ozeidan9/Autonomous-Mars-Rover/Mobile App/rover-controller/resources/background.jpg

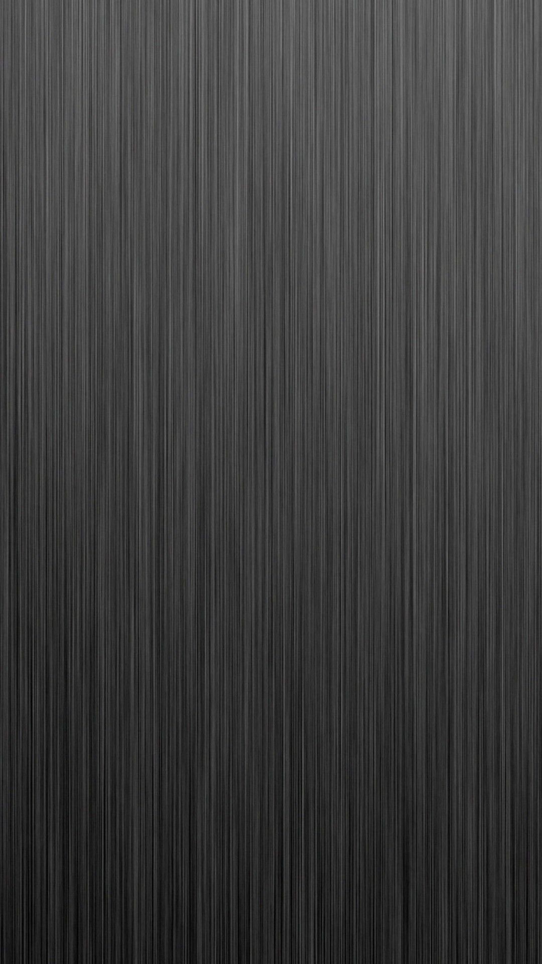
Mobile App/rover-controller/resources/background.jpg
