ozeidan9/Autonomous-Mars-Rover/Web App/Mapped_Unknown.jpg

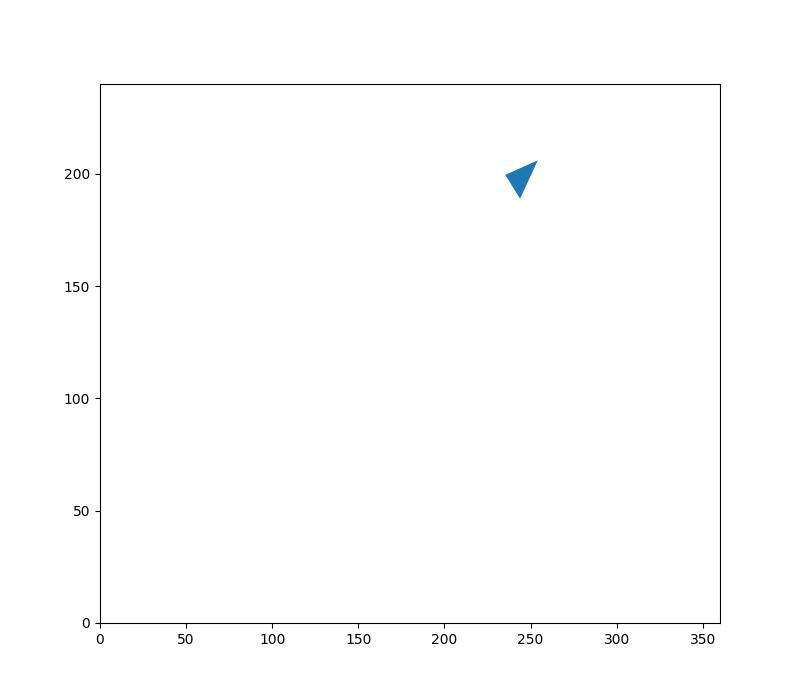
Web App/Mapped_Unknown.jpg
