ozeidan9/Autonomous-Mars-Rover/Web App/src/components/comp-resources/arena-map.jpg

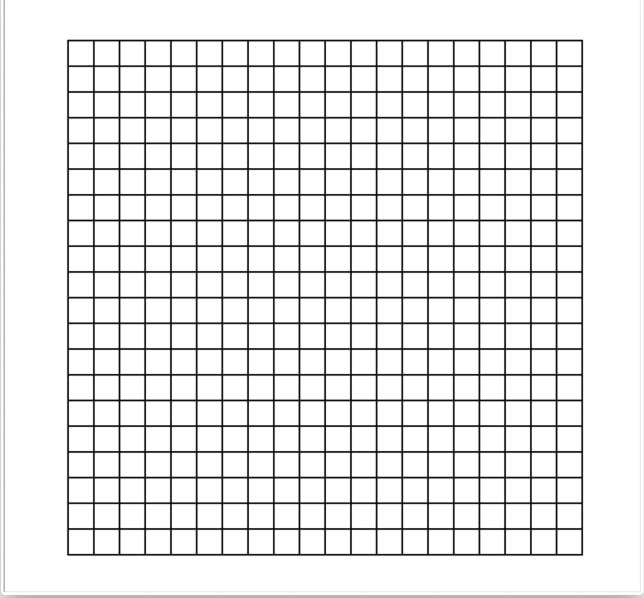
Web App/src/components/comp-resources/arena-map.jpg
