ozeidan9/Autonomous-Mars-Rover/Web App/src/components/comp-resources/Mapped_Unknown.png.jpg

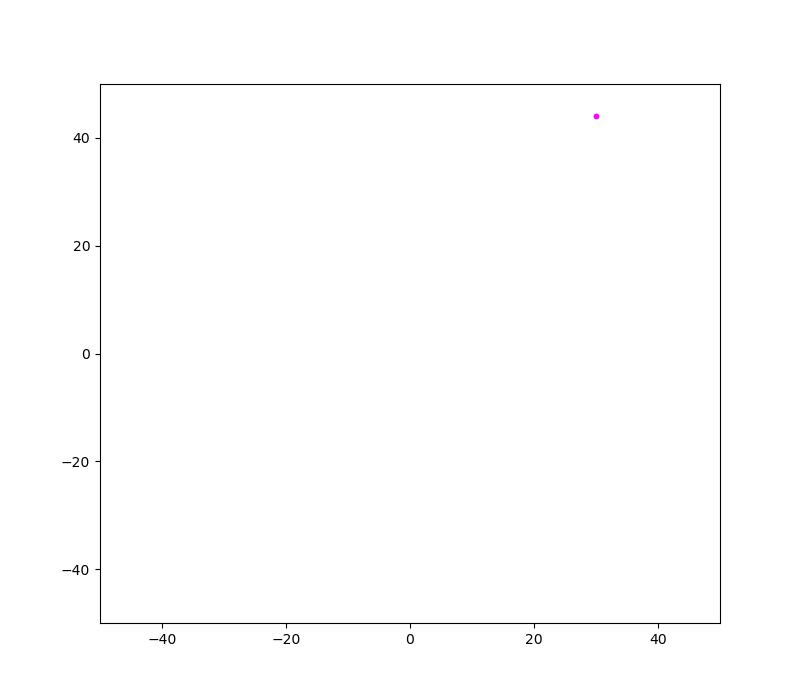
Web App/src/components/comp-resources/Mapped_Unknown.png.jpg
