ozeidan9/Autonomous-Mars-Rover/Control/Control.ino

#include "SPI.h"
#include <Robojax_L298N_DC_motor.h>
#include "WiFi.h"
//vision
bool red_found;
bool green_found;
bool yellow_found;
bool pink_found;
bool darkblue_found;
bool lightgreen_found;
int x_message;
bool building_done;
bool fourteen_reply;
unsigned long timee;
///////
//SPI settings
SPISettings settings(100000, MSBFIRST, SPI_MODE0);
SPIClass MySPI(HSPI);
uint8_t spi_counter[6]; // [0] = c20, [1] = c21, [2] = c22, [3] = c23, [4] = c24, [5] = c25
uint16_t spi_val, spi_val_prev1, spi_val_prev2;
uint16_t vision_msg;
uint8_t spi_reg;
uint16_t spi_returnval;
int spi_command;
int l;
int response;
bool will_read;
int last_read;
uint16_t colour_code;
uint16_t distrep;
uint16_t prev_distrep;
bool sent_dist;
int ball_counter = 0;
int vision_zero_counter = 0;
//////
//end of vision
bool object_measuring;
// these pins may be different on different boards
int motor1_val;
int motor2_val;
int motor_offset;
float desired = 0; //this will need to be a dynamic input connected to various things so it allows multiple directions instead of just one forward
unsigned long pathstart;//this should only be called during the update to record the time it takes for this new direction change, so this entire program needs to be called new each time the rover changes direction
//strt
//float pcoeff = 3;
//float icoeff = 0.025;
//float dcoeff = 3;
//float multiplier = 1;
float pcoeff = 3.6; //was 3.5, then 4.2
float icoeff = 0.005; //was 0.013, then 0.013
float dcoeff = 0.11; //was 0, then 0.2
float multiplier = 1;
//
//float pcoeff = 3.4;
//float icoeff = 0.02;
//float dcoeff = 3;
//float multiplier = 1;
//end
float ierror = 0;
float derror = 0;
float error;
unsigned long pathnow;
float correction;
//
uint8_t values[5];
int bytes_received;
bool angle_state = false;
bool distance_state = false;
int client_msg;
int opcode;
int magnitude;
char Commandchar;
int angle_reached;
int distance_reached;
//
#define PIN_SS        5
#define PIN_MISO      19
#define PIN_MOSI      23
#define PIN_SCK       18
#define PIN_MOUSECAM_RESET     35
#define PIN_MOUSECAM_CS        5
// TehCehPeh
#define RXP2 3
#define TXP2 1
// DRIVE
// motor 1 settings
#define CHA 0
#define ENA 2 // this pin must be PWM enabled pin if Arduino board is used D13 -> was 2
#define IN1 32 //D11
#define IN2 33 //D3 - was 15 (D12)
// motor 2 settings
#define IN3 21 //D4 //was 14  (D10)
#define IN4 16 //D9
#define ENB 17// this pin must be PWM enabled pin if Arduino board is used D8
#define CHB 1
#define ADNS3080_PIXELS_X                 30
#define ADNS3080_PIXELS_Y                 30
#define ADNS3080_PRODUCT_ID            0x00
#define ADNS3080_REVISION_ID           0x01
#define ADNS3080_MOTION                0x02
#define ADNS3080_DELTA_X               0x03
#define ADNS3080_DELTA_Y               0x04
#define ADNS3080_SQUAL                 0x05
#define ADNS3080_PIXEL_SUM             0x06
#define ADNS3080_MAXIMUM_PIXEL         0x07
#define ADNS3080_CONFIGURATION_BITS    0x0a
#define ADNS3080_EXTENDED_CONFIG       0x0b
#define ADNS3080_DATA_OUT_LOWER        0x0c
#define ADNS3080_DATA_OUT_UPPER        0x0d
#define ADNS3080_SHUTTER_LOWER         0x0e
#define ADNS3080_SHUTTER_UPPER         0x0f
#define ADNS3080_FRAME_PERIOD_LOWER    0x10
#define ADNS3080_FRAME_PERIOD_UPPER    0x11
#define ADNS3080_MOTION_CLEAR          0x12
#define ADNS3080_FRAME_CAPTURE         0x13
#define ADNS3080_SROM_ENABLE           0x14
#define ADNS3080_FRAME_PERIOD_MAX_BOUND_LOWER      0x19
#define ADNS3080_FRAME_PERIOD_MAX_BOUND_UPPER      0x1a
#define ADNS3080_FRAME_PERIOD_MIN_BOUND_LOWER      0x1b
#define ADNS3080_FRAME_PERIOD_MIN_BOUND_UPPER      0x1c
#define ADNS3080_SHUTTER_MAX_BOUND_LOWER           0x1e
#define ADNS3080_SHUTTER_MAX_BOUND_UPPER           0x1e
#define ADNS3080_SROM_ID               0x1f
#define ADNS3080_OBSERVATION           0x3d
#define ADNS3080_INVERSE_PRODUCT_ID    0x3f
#define ADNS3080_PIXEL_BURST           0x40
#define ADNS3080_MOTION_BURST          0x50
#define ADNS3080_SROM_LOAD             0x60
#define ADNS3080_PRODUCT_ID_VAL        0x17
WiFiClient client;
int distance_t = 0;
int angle_t = 0;
const int CCW = 2; // do not change
const int CW  = 1; // do not change
#define motor1 1 // do not change
#define motor2 2 // do not change
// for two motors without debug information // Watch video instruciton for this line: https://youtu.be/2JTMqURJTwg
Robojax_L298N_DC_motor robot(IN1, IN2, ENA, CHA,  IN3, IN4, ENB, CHB);
// for two motors with debug information
//Robojax_L298N_DC_motor robot(IN1, IN2, ENA, CHA, IN3, IN4, ENB, CHB, true);
char DriveMap[32]; //storage for drive's message
//char Command[32]; //storage for the actual command
const char* ssid = "AndroidAP5c48";//Wifi Name
const char* password = "janq9636";//Wifi password
const uint16_t port = 15000; //port number to connect to
const char * host = "192.168.43.192"; //IP to connect to (can be private or public)
bool drivemsgready = false; //bool which checks whether drive's message is ready for sending
bool alreadyconnected = false; //bool which checks whether the ESP32 has already connected with the server
bool Commandready = false; //bool which checks whether command is ready for sending command
bool SPIready = false;
//Event for when the ESP32 successfully connects as a Wifi Station
void WiFiConnected(WiFiEvent_t event, WiFiEventInfo_t info) {
  Serial.println("Connected to Web Backend successfully!");
}
//Event for when the ESP32 successfully receives it's local IP from the router
void WiFiGotIP(WiFiEvent_t event, WiFiEventInfo_t info) {
  Serial.println("WiFi connected");
  Serial.print("RRSI: ");
  Serial.println(WiFi.RSSI());
  Serial.println("IP address: ");
  Serial.println(WiFi.localIP());
}
//Event for when the ESP32 disconnects from the Wifi (tries to reconnect)
void WiFiDisconnected(WiFiEvent_t event, WiFiEventInfo_t info) {
  Serial.println("Disconnected from WiFi access point");
  Serial.print("WiFi lost connection. Reason: ");
  //Serial.println(info.disconnected.reason);
  Serial.println("Trying to Reconnect");
  WiFi.begin(ssid, password);
  Serial.print("Reconnecting to WiFi ..");
  while (WiFi.status() != WL_CONNECTED) {
    Serial.print('.');
    delay(1000);
  }
}
//Function for initialising connection to the WIFI
void initWiFi() {
  WiFi.mode(WIFI_STA);
  WiFi.begin(ssid, password);
  Serial.print("Connecting to WiFi ..");
  while (WiFi.status() != WL_CONNECTED) {
    Serial.print('.');
    delay(1000);
  }
}
int angle;
int total_x = 0;
int total_y = 0;
int total_x1 = 0;
int total_y1 = 0;
int x = 0;
int y = 0;
int a = 0;
int b = 0;
int distance_x = 0;
int distance_y = 0;
volatile byte movementflag = 0;
volatile int xydat[2];
//Multitasking
TaskHandle_t Optical_task;
int convTwosComp(int b) {
  //Convert from 2's complement
  if (b & 0x80) {
    b = -1 * ((b ^ 0xff) + 1);
  }
  return b;
}
struct MD
{
  byte motion;
  char dx, dy;
  byte squal;
  word shutter;
  byte max_pix;
};
int tdistance = 0;
void mousecam_reset()
{
  digitalWrite(PIN_MOUSECAM_RESET, HIGH);
  delay(1); // reset pulse >10us
  digitalWrite(PIN_MOUSECAM_RESET, LOW);
  delay(35); // 35ms from reset to functional
}
int mousecam_init()
{
  pinMode(PIN_MOUSECAM_RESET, OUTPUT);
  pinMode(PIN_MOUSECAM_CS, OUTPUT);
  digitalWrite(PIN_MOUSECAM_CS, HIGH);
  mousecam_reset();
  return 1;
}
byte frame[ADNS3080_PIXELS_X * ADNS3080_PIXELS_Y];
void mousecam_write_reg(int reg, int val)
{
  digitalWrite(PIN_MOUSECAM_CS, LOW);
  SPI.transfer(reg | 0x80);
  SPI.transfer(val);
  digitalWrite(PIN_MOUSECAM_CS, HIGH);
  delayMicroseconds(50);
}
int mousecam_read_reg(int reg)
{
  digitalWrite(PIN_MOUSECAM_CS, LOW);
  SPI.transfer(reg);
  delayMicroseconds(75);
  int ret = SPI.transfer(0xff);
  digitalWrite(PIN_MOUSECAM_CS, HIGH);
  delayMicroseconds(1);
  return ret;
}
void mousecam_read_motion(struct MD *p)
{
  digitalWrite(PIN_MOUSECAM_CS, LOW);
  SPI.transfer(ADNS3080_MOTION_BURST);
  delayMicroseconds(75);
  p->motion =  SPI.transfer(0xff);
  p->dx =  SPI.transfer(0xff);
  p->dy =  SPI.transfer(0xff);
  p->squal =  SPI.transfer(0xff);
  p->shutter =  SPI.transfer(0xff) << 8;
  p->shutter |=  SPI.transfer(0xff);
  p->max_pix =  SPI.transfer(0xff);
  digitalWrite(PIN_MOUSECAM_CS, HIGH);
  delayMicroseconds(5);
}
// pdata must point to an array of size ADNS3080_PIXELS_X x ADNS3080_PIXELS_Y
// you must call mousecam_reset() after this if you want to go back to normal operation
int mousecam_frame_capture(byte *pdata)
{
  mousecam_write_reg(ADNS3080_FRAME_CAPTURE, 0x83);
  digitalWrite(PIN_MOUSECAM_CS, LOW);
  SPI.transfer(ADNS3080_PIXEL_BURST);
  delayMicroseconds(50);
  int pix;
  byte started = 0;
  int count;
  int timeout = 0;
  int ret = 0;
  for (count = 0; count < ADNS3080_PIXELS_X * ADNS3080_PIXELS_Y; )
  {
    pix = SPI.transfer(0xff);
    delayMicroseconds(10);
    if (started == 0)
    {
      if (pix & 0x40)
        started = 1;
      else
      {
        timeout++;
        if (timeout == 100)
        {
          ret = -1;
          break;
        }
      }
    }
    if (started == 1)
    {
      pdata[count++] = (pix & 0x3f) << 2; // scale to normal grayscale byte range
    }
  }
  digitalWrite(PIN_MOUSECAM_CS, HIGH);
  delayMicroseconds(14);
  return ret;
}
void Opticaltaskcode(void *param){
  SPI.setClockDivider(SPI_CLOCK_DIV32);
  SPI.setDataMode(SPI_MODE3);
  SPI.setBitOrder(MSBFIRST);
 if (mousecam_init() == -1)
  {
    Serial.println("Mouse cam failed to init");
    while (1);
  }
  SPI.begin(); // init SPI bus
  for(;;){
    // if enabled this section produces a bar graph of the surface quality that can be used to focus the camera
    // also drawn is the average pixel value 0-63 and the shutter speed and the motion dx,dy.
    int val = mousecam_read_reg(ADNS3080_PIXEL_SUM);
    MD md;
    mousecam_read_motion(&md);
    distance_x = convTwosComp(md.dx);
    distance_y = convTwosComp(md.dy);
    total_x1 = total_x1 - distance_x;
    total_y1 = total_y1 + distance_y;
    total_x = total_x1 * 0.1008;   //callibrated;
    total_y = total_y1 * 0.0235;  //callibrated;
  }
}
void setup()
{
    timee = millis();
    object_measuring = false;
    delay(2000);
    Serial.println("started setup");
    Serial.begin(115200);
    building_done = false;
  // vision setup
    spi_val=-1;
    pinMode(15, OUTPUT);
    MySPI.begin(14, 4, 22, 15);
    spi_returnval = 0;
    red_found = 0;
    green_found = 0;
    yellow_found = 0;
    pink_found = 0;
    darkblue_found = 0;
    lightgreen_found = 0;
    response = 0;
    spi_val_prev1 = 0;
    spi_val_prev2 = 0;
 //Drive SPI setup
  pinMode(PIN_SS, OUTPUT);
  pinMode(PIN_MISO, INPUT);
  pinMode(PIN_MOSI, OUTPUT);
  pinMode(PIN_SCK, OUTPUT);
  WiFi.disconnect(true);
  robot.begin();
  //Second core shit...
  xTaskCreatePinnedToCore(
    Opticaltaskcode,
    "Optical_task",
    10000, //stack size in words
    NULL,  // input paramter to task
    0, //priority of task
    &Optical_task,
    0); //Core 0
  //initWiFi();
    WiFi.mode(WIFI_STA);
    WiFi.begin("AndroidAP5c48", "janq9636");
    Serial.print("Connecting to wifi...");
    while (WiFi.status() != WL_CONNECTED){
    Serial.print('.');
    delay(1000);
  }
  Serial.println("wifi connected");
  Serial.println(WiFi.localIP());
  client.connect(host, port);
  Serial.println("client connected");
  client.write("rover");
  Serial.println("line 547");
  sendtoServer(1, 0, 0);//initial sending of UPM
  delay(1000);
  Serial.println("end of setup");
}
char asciiart(int k)
{
  static char foo[] = "WX86*3I>!;~:,`. ";
  return foo[k >> 4];
}
//function to send sets of bytes to the server...
// void sendtoServer(int op,uint16_t first , uint16_t second){ //changed first and second to ints
//       memset(values, 0, 4); //just resetting the buffer
//       values[0] = op;
//       values[1] = (first & 65280)>>8;
//       values[2] = first & 255;
//       values[3] = (second & 65280)>>8;
//       values[4] = second & 255;
//       client.write(values, 5);
//       delay(100);
//  //sendtoSever(3,0,0)
// }
void sendtoServer(int op,int first , int second){ //changed first and second to ints
      uint16_t first_msg, second_msg;
      if(first < 0){
        first_msg = -first;
        first_msg+=32768;
      }
      else{
        first_msg = first;
      }
      if(second < 0){
        second_msg = -second;
        second_msg+=32768;
      }
      else{
        second_msg = second;
      }
      memset(values, 0, 4); //just resetting the buffer
      values[0] = op;
      values[1] = (first_msg & 65280)>>8;
      values[2] = first_msg & 255;
      values[3] = (second_msg & 65280)>>8;
      values[4] = second_msg & 255;
      client.write(values, 5);
      delay(100);
 //sendtoSever(3,0,0)
}
void loop()
{ 
  if(building_done == true & millis()-timee > 10000){
    building_done = false;
  }
  //  if((counter % 5) == 0){
  //    sendtoServer(0, 65484, 8396);
  //    counter++;
  //  }
  //  if((counter % 5) == 1){
  //    sendtoServer(1, 50, 60);
  //    counter++;
  //  }
//RE ADD ADDED ARDUINO CODE....
// start of vision loop
// Listening to vision:
    MySPI.beginTransaction(settings);
    digitalWrite(15, LOW);
    if(fourteen_reply == false){
        spi_val = MySPI.transfer16(0);
    }
    else{
        spi_val = MySPI.transfer16(14);
    }
    spi_returnval = 0;
    digitalWrite(15, HIGH);
    MySPI.endTransaction();
    if (spi_val != 0){
      Serial.println(spi_val);
    }
    if (spi_val == 9 || spi_val == 10) { 
        angle_state = true;
        if(object_measuring == false){
          Serial.println("now changing position");
          robot.brake(1);
          robot.brake(2);
          angle_t = total_x;
          distance_state = false;
          object_measuring = true;
        }
        else {
          Serial.println("started changing position");
          if(spi_val == 9){
            angle_t = total_x - 2;
          }
          else{
            angle_t = total_x + 2;
          }
        }
        distance_state = false;
        distance_t = total_y;
    }
    //no data
    else if (spi_val == 0){
        if(object_measuring){
            Serial.println("no longer measuring a ball");
            object_measuring = false;
            sendtoServer(2, 0, 0);
            sendtoServer(0, total_x, total_y);
            sendtoServer(1,0,0);
            if(fourteen_reply == true){
                fourteen_reply = false;
            }
        }
    }
    else if  (spi_val==13){
        spi_command = 0;
        SPIready = true;
        response=0;
        Serial.println("received 13. Too close!");
        ball_counter = 0;
    }
    else if  (spi_val==14){
        if(object_measuring == false & building_done == false ){
            fourteen_reply = true;
            object_measuring = true;
            robot.brake(1);
            robot.brake(2);
            angle_t = total_x;
            distance_t = total_y;
            distance_state = false;
        }
        // response=0;
        // if (will_read=true){
        // last_read=millis();
        // will_read=false;
        // spi_command = 0;
        // SPIready = true;
        // response=14;
        // sent_dist = false;
        // ball_counter = 0;
        Serial.println("received 14. requesting to measure building");
        //send back 14-                        ROHAN MA G let me know yeah
      }
    else if (spi_val ==-1){
        Serial.println("error failed to update spi connection");
        ball_counter = 0;
    }
    //detecting a ball/building
    else{
        distance_state = false;
        Serial.println("now measuring a distance");
        angle_t = total_x;
        distance_t = distance_y;
        angle_state = false;
        if(object_measuring = false){
          Serial.println("start of execution of ball measurement");
          robot.brake(1);
          robot.brake(2);
          distance_t = total_y;
          angle_t = total_x;
          angle_state = false;
          object_measuring = true;
        }
        else{
          robot.brake(1);
          robot.brake(2);
          colour_code = spi_val >> 11; //obtaining the colour code
          distrep = spi_val & 2047; //obtaining the message
          Serial.print("Colour_code: ");
          Serial.print(colour_code);
          Serial.print(" Distance: ");
          Serial.println(distrep);
          Serial.println("sending ball data to the server");
          sendtoServer(0, total_x, total_y);
          sendtoServer(2, colour_code, distrep);
          //registered the colour;
          Serial.println("telling fpga we have the data");
          MySPI.beginTransaction(settings);
          digitalWrite(15, LOW);
          if(colour_code == 7){
              spi_val = MySPI.transfer16(0);
              building_done = true;
          }
          else{
              spi_val = MySPI.transfer16(colour_code);
          }
          spi_returnval = 0;
          digitalWrite(15, HIGH);
          MySPI.endTransaction();
          delay(500);
          ball_counter = 0;
          if(fourteen_reply){
              fourteen_reply = false;
              building_done = true;
              timee = millis();
          }
          object_measuring = false;
          sendtoServer(1, 0, 0);
        }
    }
// end of vision loop
// ////////////////////////////////////////////////////////////////
// //////Receiving new command list from the server...//////////////
  Serial.println("checking for data from the server");
  if (!object_measuring && client.available())
  {
    // Serial.print("client available is high. number of bytes available is: ");
    // Serial.println(client.available());
    bytes_received = 0;
    while (client.available() && (bytes_received < 2)) {
      // Serial.println("received data from server: ");
      Commandchar = client.read(); //client.read() reads one character at a time
      // Serial.println(Commandchar);
      if(bytes_received == 0){
        client_msg = Commandchar << 8;
        // Serial.print("Halfway client message: ");
        // Serial.println(client_msg);
        bytes_received = 1;
      }
      else if(bytes_received == 1){
        client_msg += Commandchar;
        Serial.print("finished client message is: ");
        Serial.println(client_msg);
        opcode = client_msg >> 14;
        magnitude = client_msg & 16383;
        bytes_received = 2;
      }
    // Serial.print("received byte: ");
    // Serial.println(bytes_received);    
    }
    // Serial.print("Magnitude: ");
    // Serial.print(magnitude);
    //Angle
    // Serial.print("Opcode: ");
    // Serial.println(opcode);
    if(opcode==0){
        while(magnitude < 0){
          magnitude += 360;
        }
        while(magnitude > 360){
          magnitude -=360;
        }
        if(magnitude > 180 & magnitude < 360){
          magnitude = -(360-magnitude);
        }
        angle_t =  magnitude;
        distance_t = total_y;
        angle_state = true;
        distance_state = false;
        angle_reached = 0;
        distance_reached = 0;
    }
    //Dista
    else if(opcode == 1){
        if(magnitude > 500){
          distance_t = total_y -(magnitude-500);
        }else{
          distance_t = total_y + magnitude;
        }
        angle_t = total_x;
        angle_state = false;
        distance_state = true;
        angle_reached = 0;
        distance_reached = 0;
        desired = total_x;
    }
  }
      if((total_y > distance_t + 1 | total_y < distance_t - 1) && distance_state){
        distance_reached = 0;
        error =  desired - total_x;
        if(error == 0){
          ierror = 0;
        }else{
          ierror = ierror+error;
        }
        derror = error - derror;
        correction = multiplier*(error*pcoeff + ierror*icoeff + derror*dcoeff);
        if (total_y < distance_t-1){
          motor1_val = 43;
          motor2_val = 38;
          motor_offset = 3*angle_t - 3*total_x;
          robot.rotate(motor1, 44+correction, CW);//run motor1 at 60% speed in CW direction
          robot.rotate(motor2, 38-correction, CCW);//run motor1 at 60% speed in CW direction
        }
        if (total_y > distance_t + 1){
          motor1_val = 43;
          motor2_val = 38;
          motor_offset = 3*angle_t - 3*total_x;
          motor_offset = 3*angle_t - 3*total_x;
          robot.rotate(motor1, 44-correction, CCW);//run motor1 at 60% speed in CW direction
          robot.rotate(motor2, 38+correction, CW);//run motor1 at 60% speed in CW direction
        }
      }else if(distance_state){
        distance_reached = distance_reached + 1;
        robot.brake(1);
        robot.brake(2);
        //0-360 is all positive
        //-360 to 0 : 361 is -1, 362 is -2
        if(distance_reached >= 3){
          distance_reached = 0;
          distance_state = false;
          sendtoServer(0, total_x, total_y); //POS sent to server
          delay(100);
          // Serial.println("line 707");
          sendtoServer(1, 0, 0); // UPM sent to server
        }
          angle_state = false;
      }  
     if((total_x > angle_t + 1 | total_x < angle_t - 1) && angle_state){
       Serial.print("target angle is ");
       Serial.println(angle_t);
       Serial.print("actual angle is ");
       Serial.println(total_x);
       angle_reached = 0;
       if (total_x < angle_t-1){
         robot.rotate(motor1, 30, CW);//rxun motor1 at 60% speed in CW direction
         robot.rotate(motor2, 30, CW);//run motor1 at 60% speed in CW direction
       }
       if (total_x> angle_t + 1){
        //  Serial.println("too close");
         Serial.print("ideal x is: ");
        Serial.println(angle_t);
         Serial.print("total x is: ");
          Serial.println(total_x);
         robot.rotate(motor1, 30, CCW);//run motor1 at 60% speed in CW direction
         robot.rotate(motor2, 30, CCW);//run motor1 at 60% speed in CW direction
       }
     }else if(angle_state){
       angle_reached = angle_reached + 1;
       Serial.println("at correct angle");
       robot.brake(1);
       robot.brake(2);
     //0-360 is all positive
     //-360 to 0 : 361 is -1, 362 is -2
      if(angle_reached >= 3){
        robot.brake(1);
        robot.brake(2);
        angle_reached = 0;
        Serial.println("finished!");
        angle_state = false;   //RETURN LATER PLSSSSSS
        sendtoServer(0, total_x, total_y); //POS sent to server
        delay(100);
        sendtoServer(1, 0, 0); // UPM sent to server
      }
        distance_state = false;
     }
}
