ozeidan9/Autonomous-Mars-Rover/Web App/src/automate.py

from enum import auto
from operator import indexOf
import numpy as np

# map = np.zeros((240,360)) 
point=[]

poi = [ [] ]  # Points of interest
# Add corners of arena to poi
poi.append([26,26])#0
poi.append([180,26])#1
poi.append([334,26])#2
poi.append([334,214])#3
poi.append([180,214])#4
poi.append([26,214])#5
poi.append([120,120])#6
poi.append([240,120])#7


class Node(): #node class for A* pathfinding -> f = g + h

    def __init__(self, parent=None, position=None):
        self.parent = parent
        self.position = position

        self.g = 0
        self.h = 0
        self.f = 0

    def __eq__(self, other):
        return self.position == other.position


class Rover(): #node class for A* pathfinding -> f = g + h

    def __init__(self=None):

        self.distance = 0
        self.angle = 0

        self.x = 0
        self.y = 0
      

# def drive( x, y ):      #takes in current position of rover, don't we also need angle? 
    
     
#     while 0<y<360 and 0<x<240 and (manual == False):
        
#         print("brev")


def dead_zone(map, alien): #9x9 square deadzoen centred at alien or building
    
    x = alien[0]
    y = alien[1]

    
    for i in range(x-4, x+5):
        for k in range(y-4, y+5):

            if 0<=i<240 and 0<=y<360:
                map[i,k] = 1
    
    return map


def automate_route(map, start, end): # higher level function calls a star and other functions to route rover from point to point
    a_star_output = a_star(map, start, end)
    path_output = smoothbrudha(a_star_output)
    return path_output
    # sendtodrive(path_output)





def a_star(map, start, end): # closed box dead zone of 10x10 cm  -> Returns a list of tuples as a path from the given start to the given end in the given map
    # Create start and end node
    startNode = Node(None, start)
    startNode.g = startNode.h = startNode.f = 0     # A* algorothm formula for start node
    endNode = Node(None, end)
    endNode.g = endNode.h = endNode.f = 0           # A* algorothm formula for end node

    open = []   
    completed = []


    #Loop until we find the end node
    while len(open)>0:

        currentNode = open[0]  # retrieve the current node
        curr_index = 0
        for index, item in enumerate(open):
            if item.f < currentNode.f:
                currentNode = item
                curr_index = index

        # Pop current off open list, add to closed list
        open.pop(curr_index)
        completed.append(currentNode)

        # Found the goal
        if currentNode == endNode:
            path = []
            current = currentNode
            while current is not None:
                path.append(current.position)
                current = current.parent
            return path[::-1] # Return reversed path

        # Generate children
        children = []
        for new_position in [(0, -1), (0, 1), (-1, 0), (1, 0), (-1, -1), (-1, 1), (1, -1), (1, 1)]: # Adjacent squares

            # Get node position
            node_position = (currentNode.position[0] + new_position[0], currentNode.position[1] + new_position[1])

            # Make sure within range
            if node_position[0] > (len(map) - 1) or node_position[0] < 0 or node_position[1] > (len(map[len(map)-1]) -1) or node_position[1] < 0:
                continue

            # Make sure walkable terrain
            if map[node_position[0]][node_position[1]] != 0:
                continue

            # Create new node
            new_node = Node(currentNode, node_position)

            # Append
            children.append(new_node)

        # Loop through children
        for child in children:

            # Child is on the closed list
            for closed_child in completed:
                if child == closed_child:
                    continue

            # Create the f, g, and h values
            child.g = currentNode.g + 1
            child.h = ((child.position[0] - endNode.position[0]) ** 2) + ((child.position[1] - endNode.position[1]) ** 2)
            child.f = child.g + child.h

            # Child is already in the open list
            for open_node in open:
                if child == open_node and child.g > open_node.g:
                    continue

            # Add the child to the open list
            open.append(child)




def smoothbrudha(path_array): #outputs array of [angle1, distance1, angle2, distance2]
    max_x_coordnate =np.argmax( np.max(path_array, axis=0) )     #find max row element (max x element) -> axis=0 is row
    start_coordinate = path_array[0]            # initial [x,y] coordinate
    dy1 = max_x_coordnate[1] - start_coordinate[1]
    dx1 = max_x_coordnate[1] - start_coordinate[1]
    angle1 = np.arctan(dy1/dx1)
    distance1 = (dy1)^2 + (dx1)^2
    path_output = []
    path_output.append(angle1)
    path_output.append(distance1)

    end_coordinate = path_array[len(path_array)-1] 

    if max_x_coordnate==end_coordinate:
        path_output.append(0)
        path_output.append(0)
        
    else:
        dy2 = max_x_coordnate[1] - end_coordinate[1]
        dx2 = max_x_coordnate[1] - end_coordinate[1]
        angle2 = np.arctan(dy1/dx1) + angle1                # basic trig fam
        distance2 = (dy2)^2 + (dx2)^2
        path_output = []
        path_output.append(angle2)
        path_output.append(distance2)
    
    return path_output

    # implement minimum x case
    # implements if 3 corresponding x coordinates have same x value to make flat (straiught) line
    
    
    # for pos in path_array:
        

def smooth(path, weight_data = 0.5, weight_smooth = 0.1, tolerance = 0.00001):
    
    # Make a deep copy of path into newpath
    newpath = [[0 for col in range(len(path[0]))] for row in range(len(path))]
    for i in range(len(path)):
        for j in range(len(path[0])):
            newpath[i][j] = path[i][j]

    #### ENTER CODE BELOW THIS LINE ###
    change = 1
    while change > tolerance:
        change = 0
        for i in range(1,len(path)-1):
            for j in range(len(path[0])):
                ori = newpath[i][j]
                newpath[i][j] = newpath[i][j] + weight_data*(path[i][j]-newpath[i][j])
                newpath[i][j] = newpath[i][j] + weight_smooth*(newpath[i+1][j]+newpath[i-1][j]-2*newpath[i][j])
                change += abs(ori - newpath[i][j])
    
    return newpath # Leave this line for the grader!


    
def send_angle(angle):
    target_angle = rover.angle + angle
    return target_angle

def send_distance(distance):
    target_distance = rover.distance + distance
    return target_distance


def sendtodrive(path_output):
    for name in nicknames:
        if name=="rover":
            index = indexOf(name)
            break

    client = clients[index]
    #Add queue system...
    client.send["yo"]



#adv def CurvatiousBundaliciousBattyBunds():
def update_start(x,y,angle):
    if x == 20:
        if y==20:
            #driveto(26,26,90)
            stateinner= 0
        if y==220:
            #driveto(26,214,180)
            stateinner= 5
    if x == 340:
        if y==20:
            #driveto(334,26,-90)
            stateinner= 2
        if y==220:
            #driveto(324,214,0)
            stateinner= 3
    return (stateinner)
    

# def driveto(x,y,angle):

#     init_x = rover.x
#     init_y = rover.y
#     curr_loc = [init_x, init_y]

#     new_loc = calc_loc(angle,  ,curr_loc)
#     rover.x = new_loc[0]
#     rover.y = new_loc[1]



def nextpoint(state, poi,map):
    line_path = automate_route(map ,poi[point-1], poi[point])  # line_path = [angle1, d1, angle2, d2]
    return (line_path)
    #send to drive
    #sendtodrive

def command(point,state):
    line_path = automate_route(map ,poi[point], poi[point+1]) 
    if (point == 1 or point == 4):
        command.clear()
        command.append("6155") # left 155
        command.append("7155") #right 155
        

    if (point == 6 or point == 7):
        command.append("6180") # left 180
        command.append("6180") # left 180 
        
    else:
        command.append("9000") #radar on
        command.append("6065") # left 65
        command.append("7065") #right 65
        command.append("9100") #radar off
        print(command)
        return command

def exe(x,y,angle,state,serverstate):
    if serverstate == 1 :
        state=update_start(x,y)
    if serverstate==0:
        commandlist = command(point,state)
    
    return commandlist
    
