ozeidan9/Autonomous-Mars-Rover/Web App/src/automation_simulation.py

from cmath import sqrt
import numpy as np
import math


# start: 24,24
# end: 180,26


class Node():
    """A node class for A* Pathfinding"""

    def __init__(self, parent=None, position=None):
        self.parent = parent
        self.position = position

        self.g = 0
        self.h = 0
        self.f = 0

    def __eq__(self, other):
        return self.position == other.position

def astar(maze, start, end):
    """Returns a list of tuples as a path from the given start to the given end in the given maze"""

    # Create start and end node
    start_node = Node(None, start)
    start_node.g = start_node.h = start_node.f = 0
    end_node = Node(None, end)
    end_node.g = end_node.h = end_node.f = 0

    # Initialize both open and closed list
    open_list = []
    closed_list = []

    # Add the start node
    open_list.append(start_node)

    # Loop until you find the end
    while len(open_list) > 0:

        # Get the current node
        current_node = open_list[0]
        current_index = 0
        for index, item in enumerate(open_list):
            if item.f < current_node.f:
                current_node = item
                current_index = index

        # Pop current off open list, add to closed list
        open_list.pop(current_index)
        closed_list.append(current_node)

        # Found the goal
        if current_node == end_node:
            path = []
            current = current_node
            while current is not None:
                path.append(current.position)
                current = current.parent
            return path[::-1] # Return reversed path

        # Generate children
        children = []
        for new_position in [(0, -1), (0, 1), (-1, 0), (1, 0), (-1, -1), (-1, 1), (1, -1), (1, 1)]: # Adjacent squares

            # Get node position
            node_position = (current_node.position[0] + new_position[0], current_node.position[1] + new_position[1])

            # Make sure within range
            if node_position[0] > (len(maze) - 1) or node_position[0] < 0 or node_position[1] > (len(maze[len(maze)-1]) -1) or node_position[1] < 0:
                continue

            # Make sure walkable terrain
            if maze[node_position[0]][node_position[1]] != 0:
                continue

            # Create new node
            new_node = Node(current_node, node_position)

            # Append
            children.append(new_node)

        # Loop through children
        for child in children:

            # Child is on the closed list
            for closed_child in closed_list:
                if child == closed_child:
                    continue

            # Create the f, g, and h values
            child.g = current_node.g + 1
            child.h = ((child.position[0] - end_node.position[0]) ** 2) + ((child.position[1] - end_node.position[1]) ** 2)
            child.f = child.g + child.h

            # Child is already in the open list
            for open_node in open_list:
                if child == open_node and child.g > open_node.g:
                    continue

            # Add the child to the open list
            open_list.append(child)


def straight_path(path):
    new_path = []
    x = []
    y = []
    new_path.append((path[0][0], path[0][1]))
    count = 0
    m = 0
    m_prev = -1

   

    m_count = 0
    for i in range(1,len(path)):
        if (path[i][0] - path[i-1][0])!=0:
            m = (path[i][1] - path[i-1][1]) / (path[i][0] - path[i-1][0]) #dy/dx
            # print(m)

        # print(m)
        condition = abs(m - m_prev)<=0.8  # bool condition
        if condition:
            m_count+=1
        # print(abs(m - m_prev))
        if condition==False and m_count>=2:
            # new_path.append((path[i-1][0], path[i-1][1]))
            new_path.append((path[i][0], path[i][1]))

            point_check = new_path.index((path[i-m_count-2][0], path[i-m_count-2][1]))
            if not (point_check>=0):
                new_path.append((path[i-m_count-2][0], path[i-m_count-2][1]))

            # print(m_count)
            m_count = 0

        m_prev = m


    if new_path[len(new_path)-1]!=path[len(path)-1]:
        new_path.append(path[len(path)-1])

    return new_path





def make_circle(map, cx, cy):
    for x in range(cx - 10, cx + 10):
        for y in range(cy - 10, cy + 10):
            if math.sqrt((cx - x) ** 2 + (cy - y) ** 2) <= 10 and 0<=x<240 and 0<=y<360:
                map[x][y] = 1



def make_border(map):
    # left border
    for y in range(0, 360):
        for x in range(0, 11):
            map[y][x] = 1

    # right border
    for y in range(0, 360):
        for x in range(229, 240):
            map[y][x] = 1
    # bottom border
    for y in range(0, 10):
        for x in range(0, 240):
            map[y][x] = 1

    # top border
    for y in range(349, 360):
        for x in range(0, 240):
            map[y][x] = 1




def extract_commands(path_array): #outputs array of [angle1, distance1, angle2, distance2]
    path_output = []
    for i in range(0, len(path_array)-1):
        if (path_array[i+1][1]-path_array[i][1])>=0 and (path_array[i+1][0]-path_array[i][0])<0:
            print("case 1")
            
            adjacent = path_array[i+1][0] - path_array[i][0]
            opposite = path_array[i+1][1] - path_array[i][1]
            print(adjacent)
            print(opposite)
            if adjacent==0:
                pos_angle = 0
            else:
                pos_angle = math.degrees(np.arctan(opposite/adjacent))
                pos_angle += 360
                distance = pow(pow(adjacent, 2) + pow(opposite, 2), 0.5)
                path_output.append(int(pos_angle))
                path_output.append(int(distance))



        elif (path_array[i+1][1]-path_array[i][1])<0:
            print("case 2")
            adjacent = path_array[i+1][0] - path_array[i][0]
            opposite = path_array[i+1][1] - path_array[i][1]

            if adjacent==0:
                pos_angle = 0
            else:
                pos_angle = math.degrees(np.arctan(opposite/adjacent))
                pos_angle += 180

                distance = pow(pow(adjacent, 2) + pow(opposite, 2), 0.5)
                path_output.append(int(pos_angle))
                path_output.append(int(distance))

        elif (path_array[i+1][1]-path_array[i][1])>=0 and (path_array[i+1][0]-path_array[i][0])<0:
            print("case 3")
            

            adjacent = path_array[i+1][0] - path_array[i][0]
            opposite = path_array[i+1][1] - path_array[i][1]
            print(adjacent)
            print(opposite)
            # print("opposite is: "+ str(opposite))
            # print("adjacent is: "+ str(adjacent))
            if adjacent==0:
                pos_angle = 0
            else:
                pos_angle = math.degrees(np.arctan(opposite/adjacent))
                distance = pow(pow(adjacent, 2) + pow(opposite, 2), 0.5)
                path_output.append(int(pos_angle))
                path_output.append(int(distance))


        else: # dx and dy both >=0
            print("case 4")
            
            adjacent = path_array[i+1][0] - path_array[i][0]
            opposite = path_array[i+1][1] - path_array[i][1]
            print(adjacent)
            print(opposite)
            if adjacent==0:
                pos_angle = 0
            else:
                pos_angle = math.degrees(np.arctan(opposite/adjacent))
                distance = pow(pow(adjacent, 2) + pow(opposite, 2), 0.5)
                path_output.append(int(pos_angle))
                path_output.append(int(distance))



    return path_output


def make_border(map_temp):
    # left border
    for y in range(0, 360):
        for x in range(0, 11):
            map_temp[y][x] = 1

    # right border
    for y in range(0, 360):
        for x in range(229, 240):
            map_temp[y][x] = 1
    # bottom border
    for y in range(0, 10):
        for x in range(0, 240):
            map_temp[y][x] = 1

    # top border
    for y in range(349, 360):
        for x in range(0, 240):
            map_temp[y][x] = 1



# def automate_route(map, start, end):
#     a_star_path = astar(map, start, end)
#     straight_route = straight_path(a_star_path)
#     return extract_commands()


def main():
    
    maze = np.zeros((360, 240))

    start = (24, 24)
    end = (180,26)


    make_circle(maze, 50, 100)
    make_circle(maze, 90, 65)


  
    make_border(maze)

    # print(maze)

    path = astar(maze, start, end)
    print("A star: ")
    print(path)

    # print("x is: ")
    # for i in range(0, len(path)):
    #     print(path[i][0])

    # print("y is: ")
    # for i in range(0, len(path)):
    #     print(path[i][1])


   
    critical_points = straight_path(path)
    print("Critical point algo: ")
    print(critical_points)

    # print("critical x is: ")
    # for i in range(0, len(critical_points)):
    #     print(critical_points[i][0])

    # print("critical y is: ")
    # for i in range(0, len(critical_points)):
    #     print(critical_points[i][1])

    commands = extract_commands(critical_points)
    print("commands are: ")
    for i in range(0, len(commands)):
        print(commands[i])


if __name__ == '__main__':
    main()
