ozeidan9/Autonomous-Mars-Rover/(commit log)

2022-06-07 threaded server
2022-06-22 [update] buildings and colour calibration
2022-06-24 [update] vision added
    [DE10_LITE_D8M_VIP.smp_dump.txt]
